Blinkinlabs/BlinkyPendant/README.md

# BlinkyPendant

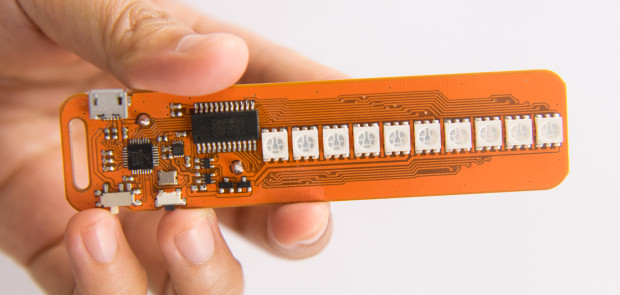
[picture p1: documentation/blinkypendant.jpg]


The BlinkyPendant is a pocket-sized POV wand, perfect for making light effects on the go!

See [http://blinkypendant.com](http://blinkypendant.com) for more details.
