Blinkinlabs/BlinkyPendant/pcb/art/BlinkyPendant.BMP

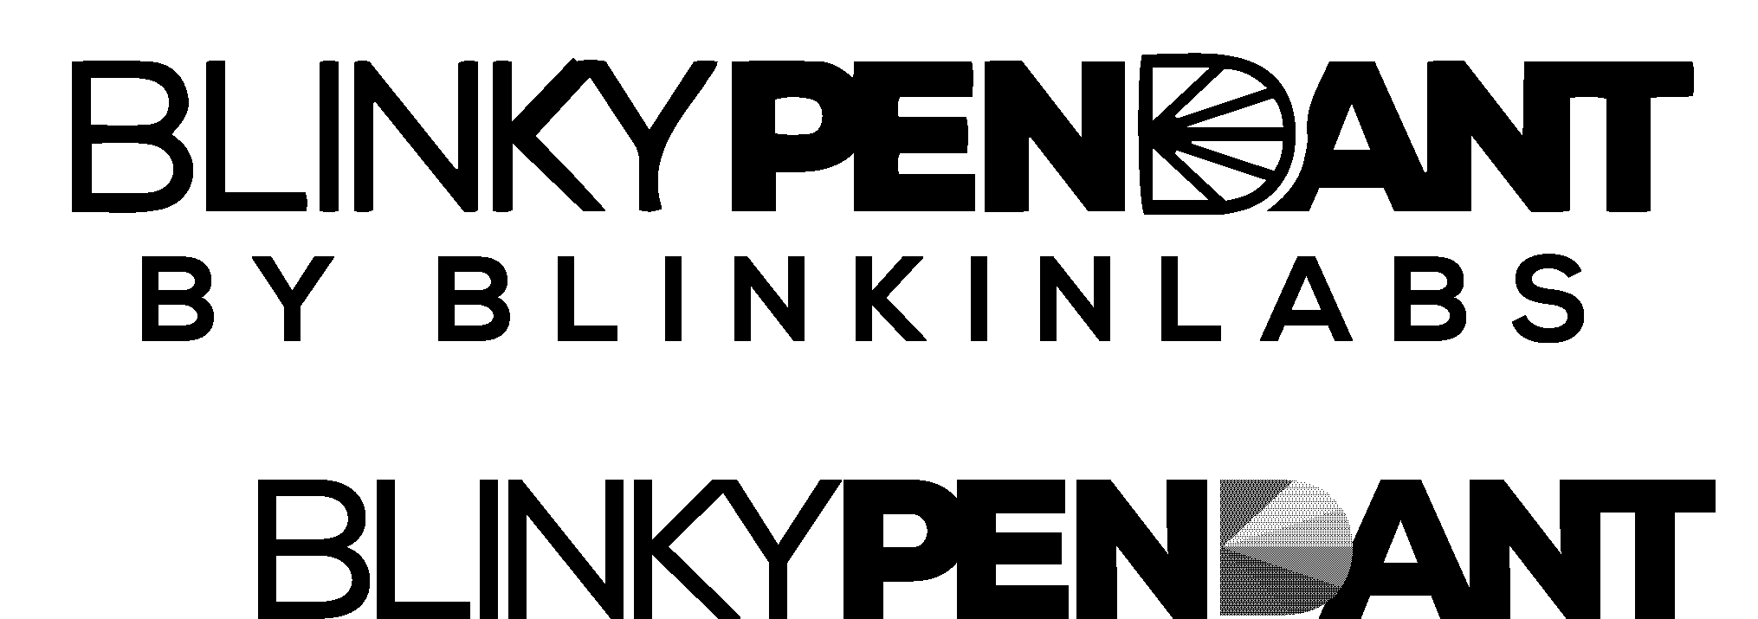
pcb/art/BlinkyPendant.BMP
