Blinkinlabs/BlinkyPendant/pcb/art/KinetisConnects_blackTEXT-1.BMP

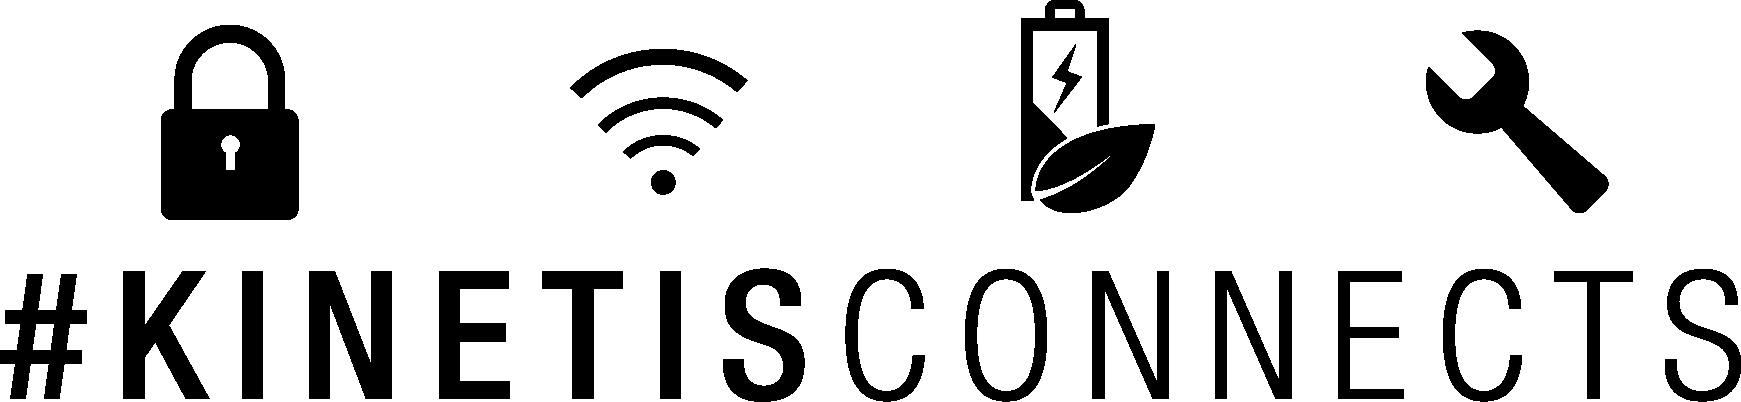
pcb/art/KinetisConnects_blackTEXT-1.BMP
