Blinkinlabs/BlinkyPendant/production/testcard/controller testjig.brd

## EAGLE design production/testcard/controller testjig.brd (2015-05-27)

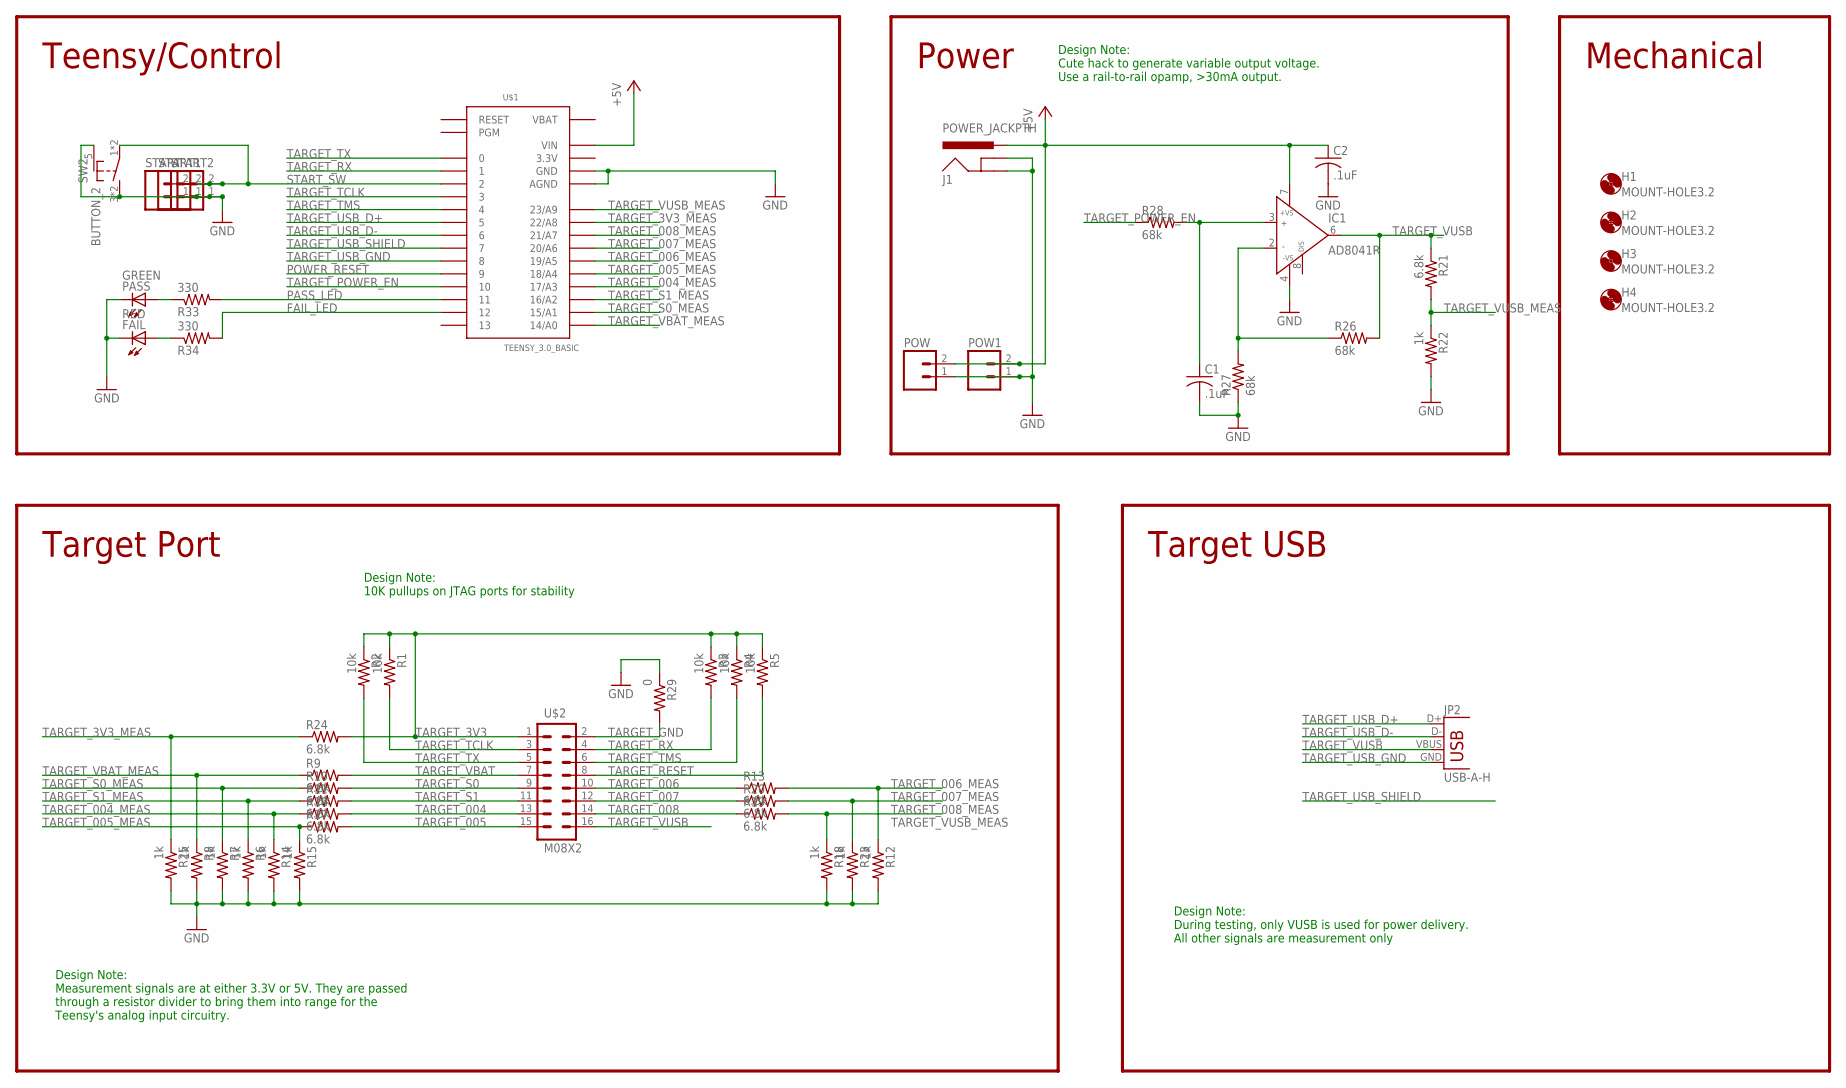
[picture p4: schematic controller testjig.sch]

Parts:
C1, C2: .1uF; C0603
FAIL: RED; LED5MM
H1, H2, H3, H4: MOUNT-HOLE3.2; 3,2
IC1: AD8041R; SO8
J1: POWER_JACKPTH; POWER_JACK_PTH
JP2: USB-A-H
PASS: GREEN; LED5MM
POW, POW1: M02; 02P
R1, R2, R3, R4, R5: 10k; R0603
R6, R7, R8, R12, R14, R15, R18, R22, R23, R25: 1k; R0603
R9, R10, R11, R13, R16, R17, R19, R20, R21, R24: 6.8k; R0603
R26, R27, R28: 68k; R0603
R29: 0; R0603
R33, R34: 330; R0603
START, START1, START2: M02; 02P
SW2: BUTTON_2; TD-07XB
U$1: TEENSY_3.0_BASIC
U$2: M08X2; 2X8

Connections:
3.3V: U$1.3.3V, U$1.3.3V1 (3.3V)
+5V: C2.1, IC1.7 (+VS), J1.PWR, POW.2, POW1.2, U$1.VIN
FAIL_LED: R34.2, U$1.12
GND: C1.2, C2.2, FAIL.K (C), IC1.4 (-VS), J1.GND, J1.GNDBREAK, PASS.K (C), POW.1, POW1.1, R6.2, R7.2, R8.2, R12.2, R14.2, R15.2, R18.2, R22.2, R23.2, R25.2, R27.1, R29.1, START.1, START1.1, START2.1, SW2.3 (S), SW2.4 (S), SW2.5 (SHIELD), U$1.AGND, U$1.GND, U$1.GND1 (GND)
GOOD: PASS.A, R33.1
unnamed: IC1.2 (IN-), R26.1, R27.2
unnamed: C1.1, IC1.3 (IN+), R28.2
unnamed: FAIL.A, R34.1
PASS_LED: R33.2, U$1.11
POWER_RESET: U$1.9
START_SW: START.2, START1.2, START2.2, SW2.1, SW2.2, U$1.2
TARGET_3V3: R1.1, R2.1, R3.1, R4.1, R5.1, R24.2, U$2.1
TARGET_3V3_MEAS: R24.1, R25.1, U$1.22/A8
TARGET_004: R16.2, U$2.13
TARGET_004_MEAS: R14.1, R16.1, U$1.17/A3
TARGET_005: R17.2, U$2.15
TARGET_005_MEAS: R15.1, R17.1, U$1.18/A4
TARGET_006: R13.1, U$2.10
TARGET_006_MEAS: R12.1, R13.2, U$1.19/A5
TARGET_007: R20.1, U$2.12
TARGET_007_MEAS: R20.2, R23.1, U$1.20/A6
TARGET_008: R19.1, U$2.14
TARGET_008_MEAS: R18.1, R19.2, U$1.21/A7
TARGET_GND: R29.2, U$2.2
TARGET_POWER_EN: R28.1, U$1.10
TARGET_RESET: R5.2, U$2.8
TARGET_RX: R3.2, U$1.1, U$2.4
TARGET_S0: R10.2, U$2.9
TARGET_S0_MEAS: R7.1, R10.1, U$1.15/A1
TARGET_S1: R11.2, U$2.11
TARGET_S1_MEAS: R6.1, R11.1, U$1.16/A2
TARGET_TCLK: R1.2, U$1.3, U$2.3
TARGET_TMS: R4.2, U$1.4, U$2.6
TARGET_TX: R2.2, U$1.0, U$2.5
TARGET_USB_D+: JP2.D+, U$1.5
TARGET_USB_D-: JP2.D-, U$1.6
TARGET_USB_GND: JP2.GND, U$1.8
TARGET_USB_SHIELD: U$1.7
TARGET_VBAT: R9.2, U$2.7
TARGET_VBAT_MEAS: R8.1, R9.1, U$1.14/A0
TARGET_VUSB: IC1.6 (OUT), JP2.VBUS, R21.1, R26.2, U$2.16
TARGET_VUSB_MEAS: R21.2, R22.1, U$1.23/A9
VBAT: U$1.VBAT

Notes on the sheet:
Teensy/Control
Target Port
Design Note: Measurement signals are at either 3.3V or 5V. They are passed through a resistor divider to bring them into range for the Teensy's analog input circuitry.
Design Note: 10K pullups on JTAG ports for stability
Mechanical
Target USB
Power
Design Note: During testing, only VUSB is used for power delivery. All other signals are measurement only
Design Note: Cute hack to generate variable output voltage. Use a rail-to-rail opamp, >30mA output.

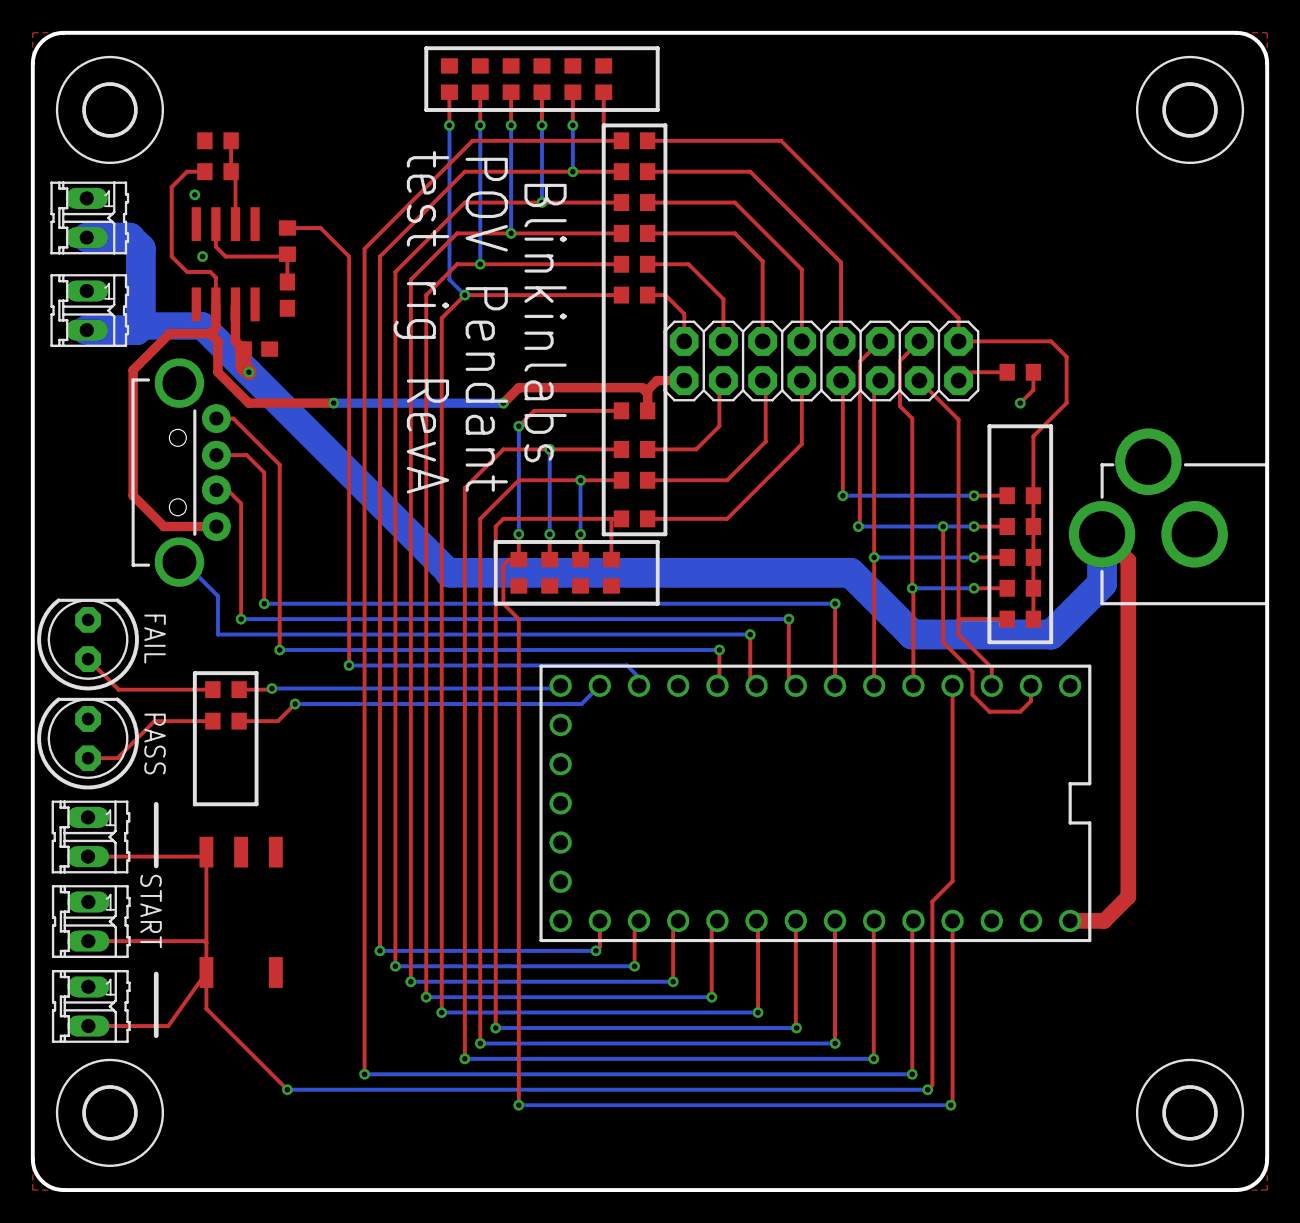
[picture p5: board controller testjig.brd from above]

Board: 2 copper layers, 80.0 x 75.0 mm, 50 parts (0 on the bottom side), 40 nets.
