Blinkinlabs/BlinkyPendant/pcb/pendant.brd

## EAGLE design pcb/pendant.brd (2015-05-27)

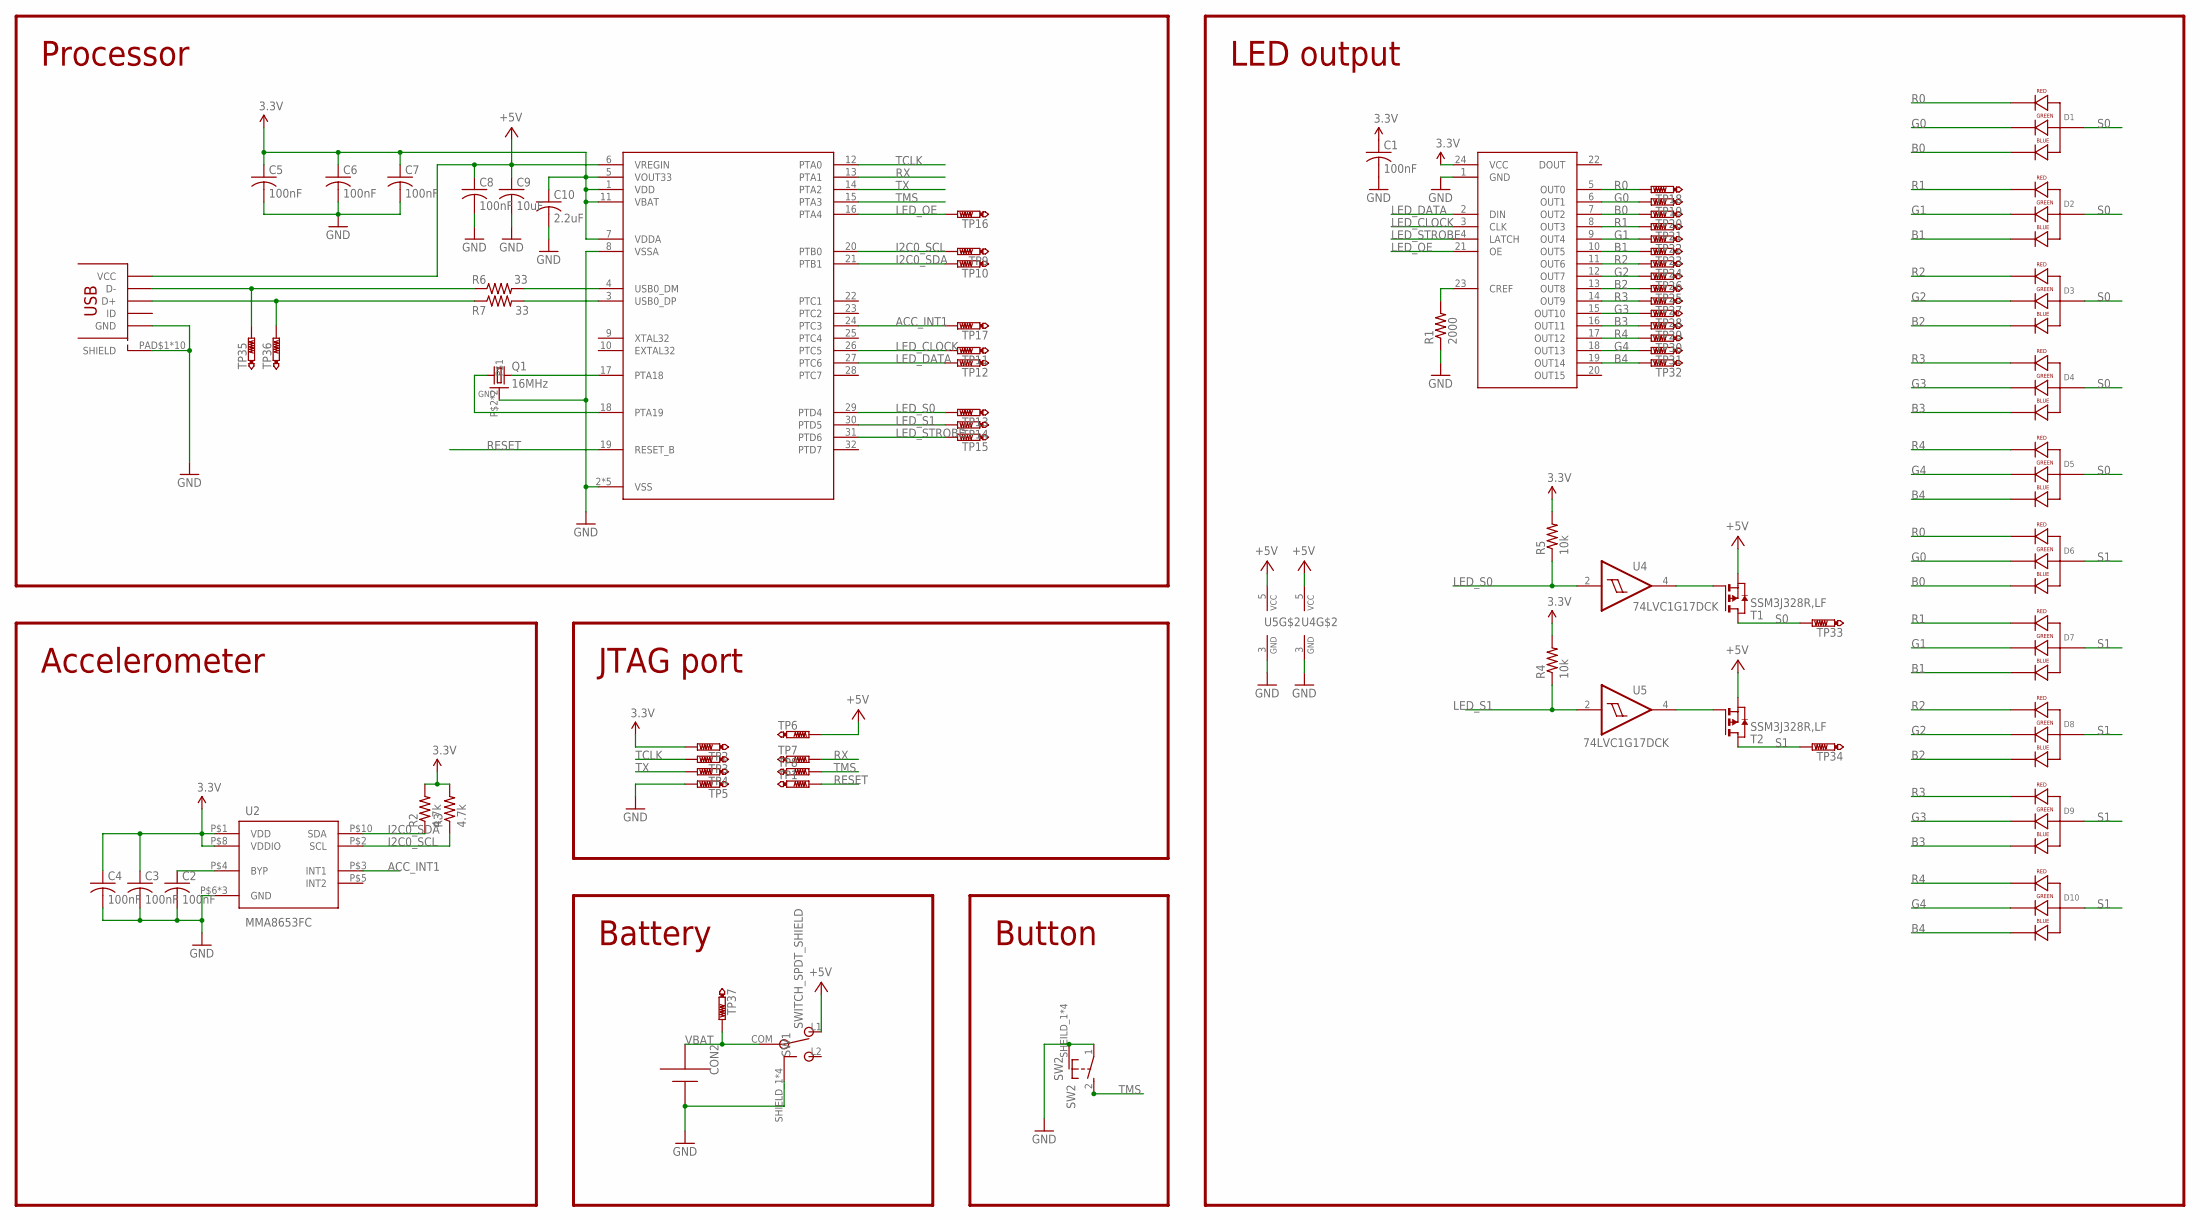
[picture p6: schematic pendant.sch]

Parts:
C1, C2, C3, C4, C5, C6, C7, C8: 100nF; C0402
C9: 10uF; C0603
C10: 2.2uF; C0402
CON1: USB_MICROSMT+THRUHULE; USB_MICRO_THRUHOLE
CON2: CR2032X2
D1, D2, D3, D4, D5, D6, D7, D8, D9, D10: LED-RGB5050; LED-TRICOLOR-5050-FIXED
Q1: 16MHz; CRYSTAL_3225
R1: 2000; R0402
R2, R3: 4.7k; R0402
R4, R5: 10k; R0402
R6, R7: 33; R0402
SW1: SWITCH_SPDT_SHIELD; SWITCH_SMD_90_DEGREE
SW2: SW2; BUTTON_MOMENTARY_MP5
T1, T2: SSM3J328R,LF; SOT-23
TP1, TP2, TP3, TP4, TP5, TP6, TP7, TP8, TP9, TP10, TP11, TP12, TP13, TP14, TP15, TP16, TP17, TP18, TP19, TP20, TP21, TP22, TP23, TP24, TP25, TP26, TP27, TP28, TP29, TP30, TP31, TP32, TP33, TP34, TP35, TP36, TP37: PTR1B1,27; B1,27
U1: MK20D--VFM5; QFN32_5X5_LONGLEADS
U2: MMA8653FC; VFDFN-10
U3: ICN2026DF; SMD-24-1MM
U4, U5: 74LVC1G17DCK; SC70-5

Connections:
3.3V: C1.1, C3.1, C4.1, C5.1, C6.1, C7.1, C10.1, R2.2, R3.2, R4.2, R5.2, TP2.TP, U1.1 (VDD), U1.5 (VOUT33), U1.7 (VDDA), U1.11 (VBAT), U2.P$1 (VDD), U2.P$8 (VDDIO), U3.24 (VCC)
+5V: C8.1, C9.1, CON1.PIN$1 (VCC), SW1.L1, T1.2 (S), T2.2 (S), TP6.TP, U1.6 (VREGIN), U4.5 (VCC), U5.5 (VCC)
ACC_INT1: TP17.TP, U1.24 (PTC3), U2.P$3 (INT1)
B0: D1.1 (BLUE_CATHODE), D6.1 (BLUE_CATHODE), TP20.TP, U3.7 (OUT2)
B1: D2.1 (BLUE_CATHODE), D7.1 (BLUE_CATHODE), TP23.TP, U3.10 (OUT5)
B2: D3.1 (BLUE_CATHODE), D8.1 (BLUE_CATHODE), TP25.TP, U3.13 (OUT8)
B3: D4.1 (BLUE_CATHODE), D9.1 (BLUE_CATHODE), TP29.TP, U3.16 (OUT11)
B4: D5.1 (BLUE_CATHODE), D10.1 (BLUE_CATHODE), TP32.TP, U3.19 (OUT14)
G0: D1.3 (GREEN_CATHODE), D6.3 (GREEN_CATHODE), TP19.TP, U3.6 (OUT1)
G1: D2.3 (GREEN_CATHODE), D7.3 (GREEN_CATHODE), TP22.TP, U3.9 (OUT4)
G2: D3.3 (GREEN_CATHODE), D8.3 (GREEN_CATHODE), TP26.TP, U3.12 (OUT7)
G3: D4.3 (GREEN_CATHODE), D9.3 (GREEN_CATHODE), TP28.TP, U3.15 (OUT10)
G4: D5.3 (GREEN_CATHODE), D10.3 (GREEN_CATHODE), TP31.TP, U3.18 (OUT13)
GND: C1.2, C2.2, C3.2, C4.2, C5.2, C6.2, C7.2, C8.2, C9.2, C10.2, CON1.PAD$1 (SHIELD), CON1.PAD$2 (SHIELD), CON1.PAD$3 (SHIELD), CON1.PAD$4 (SHIELD), CON1.PAD$5 (SHIELD), CON1.PAD$6 (SHIELD), CON1.PAD$7 (SHIELD), CON1.PAD$8 (SHIELD), CON1.PAD$9 (SHIELD), CON1.PAD$10 (SHIELD), CON1.PIN$5 (GND), CON2.-, Q1.P$2, Q1.P$4, R1.1, SW1.SHIELD_1 (SHIELD), SW1.SHIELD_2 (SHIELD), SW1.SHIELD_3 (SHIELD), SW1.SHIELD_4 (SHIELD), SW2.1, SW2.SHEILD_1 (SHIELD), SW2.SHEILD_2 (SHIELD), SW2.SHEILD_3 (SHIELD), SW2.SHEILD_4 (SHIELD), TP5.TP, U1.2 (VSS), U1.8 (VSSA), U1.PAD@1 (VSS), U1.PAD@4 (VSS), U1.PAD@9 (VSS), U1.PAD@11 (VSS), U2.P$6 (GND), U2.P$7 (GND), U2.P$9 (GND), U3.1 (GND), U4.3 (GND), U5.3 (GND)
I2C0_SCL: R3.1, TP9.TP, U1.20 (PTB0), U2.P$2 (SCL)
I2C0_SDA: R2.1, TP10.TP, U1.21 (PTB1), U2.P$10 (SDA)
LED_CLOCK: TP11.TP, U1.26 (PTC5), U3.3 (CLK)
LED_DATA: TP12.TP, U1.27 (PTC6), U3.2 (DIN)
LED_OE: TP16.TP, U1.16 (PTA4), U3.21 (OE)
LED_S0: R5.1, TP13.TP, U1.29 (PTD4), U4.2 (I)
LED_S1: R4.1, TP14.TP, U1.30 (PTD5), U5.2 (I)
LED_STROBE: TP15.TP, U1.31 (PTD6), U3.4 (LATCH)
unnamed: T2.3 (G), U5.4 (O)
unnamed: C2.1, U2.P$4 (BYP)
unnamed: T1.3 (G), U4.4 (O)
unnamed: Q1.P$3 (2), U1.17 (PTA18)
unnamed: Q1.P$1 (1), U1.18 (PTA19)
unnamed: CON1.PIN$3 (D+), R7.1, TP36.TP
unnamed: R6.2, U1.4 (USB0_DM)
unnamed: R7.2, U1.3 (USB0_DP)
unnamed: R1.2, U3.23 (CREF)
unnamed: CON1.PIN$2 (D-), R6.1, TP35.TP
R0: D1.2 (RED_CATHODE), D6.2 (RED_CATHODE), TP18.TP, U3.5 (OUT0)
R1: D2.2 (RED_CATHODE), D7.2 (RED_CATHODE), TP21.TP, U3.8 (OUT3)
R2: D3.2 (RED_CATHODE), D8.2 (RED_CATHODE), TP24.TP, U3.11 (OUT6)
R3: D4.2 (RED_CATHODE), D9.2 (RED_CATHODE), TP27.TP, U3.14 (OUT9)
R4: D5.2 (RED_CATHODE), D10.2 (RED_CATHODE), TP30.TP, U3.17 (OUT12)
RESET: TP1.TP, U1.19 (RESET_B)
RX: TP7.TP, U1.13 (PTA1)
S0: D1.4 (ANODE), D1.5 (ANODE), D1.6 (ANODE), D2.4 (ANODE), D2.5 (ANODE), D2.6 (ANODE), D3.4 (ANODE), D3.5 (ANODE), D3.6 (ANODE), D4.4 (ANODE), D4.5 (ANODE), D4.6 (ANODE), D5.4 (ANODE), D5.5 (ANODE), D5.6 (ANODE), T1.1 (D), TP33.TP
S1: D6.4 (ANODE), D6.5 (ANODE), D6.6 (ANODE), D7.4 (ANODE), D7.5 (ANODE), D7.6 (ANODE), D8.4 (ANODE), D8.5 (ANODE), D8.6 (ANODE), D9.4 (ANODE), D9.5 (ANODE), D9.6 (ANODE), D10.4 (ANODE), D10.5 (ANODE), D10.6 (ANODE), T2.1 (D), TP34.TP
TCLK: TP3.TP, U1.12 (PTA0)
TMS: SW2.2 (S), TP8.TP, U1.15 (PTA3)
TX: TP4.TP, U1.14 (PTA2)
VBAT: CON2.+, SW1.COM, TP37.TP

Notes on the sheet:
Accelerometer
LED output
Processor
JTAG port
Battery
Button

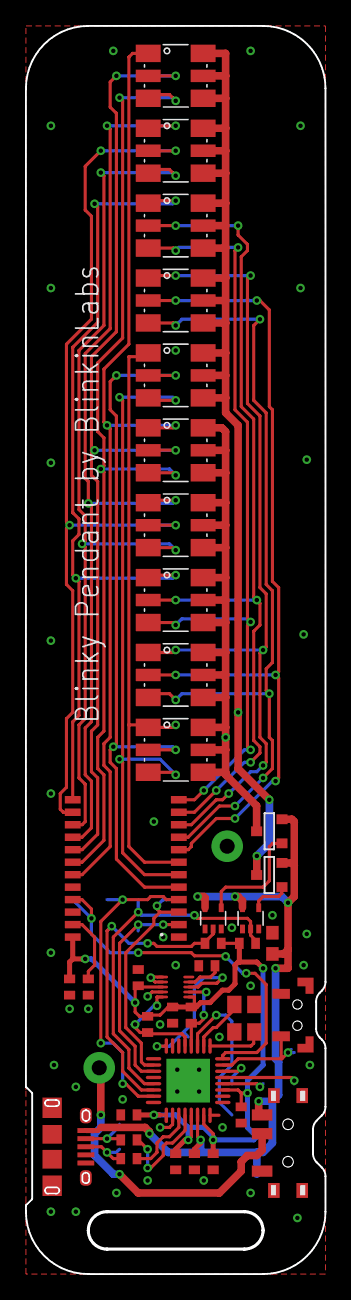
[picture p7: board pendant.brd from above]

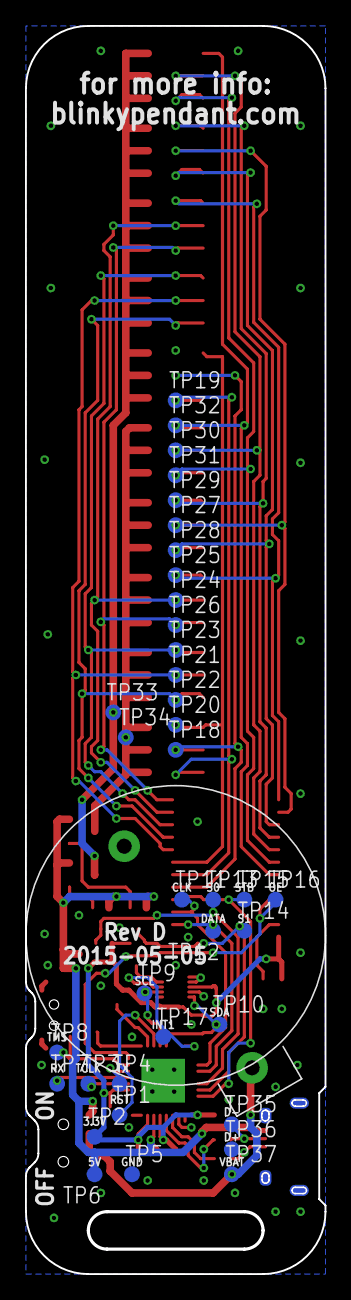
[picture p8: board pendant.brd from below]

Board: 2 copper layers, 24.0 x 100.0 mm, 76 parts (38 on the bottom side), 45 nets.
