Blinkinlabs/BlinkyPendant/production/test/production/fc_remote.cpp

/*
 * Remote control for the Fadecandy firmware, using the ARM debug interface.
 * 
 * Copyright (c) 2013 Micah Elizabeth Scott
 * 
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
 * THE SOFTWARE IS PROVIDED "AS IS", WITHOUT WARRANTY OF ANY KIND, EXPRESS OR
 * IMPLIED, INCLUDING BUT NOT LIMITED TO THE WARRANTIES OF MERCHANTABILITY, FITNESS
 * FOR A PARTICULAR PURPOSE AND NONINFRINGEMENT. IN NO EVENT SHALL THE AUTHORS OR
 * COPYRIGHT HOLDERS BE LIABLE FOR ANY CLAIM, DAMAGES OR OTHER LIABILITY, WHETHER
 * IN AN ACTION OF CONTRACT, TORT OR OTHERWISE, ARISING FROM, OUT OF OR IN
 * CONNECTION WITH THE SOFTWARE OR THE USE OR OTHER DEALINGS IN THE SOFTWARE.
 */

#include <Arduino.h>
#include "fc_remote.h"
#include "testjig.h"
#include "firmware_data.h"
#include "mma8653_defines.h"

// TODO: DELETE ME!
#define fw_pFlags 0x00FFFFFF
#define fw_pFbPrev 0x00FFFFFF
#define fw_pFbNext 0x00FFFFFF
#define fw_pLUT 0x00FFFFFF
#define fw_usbPacketBufOffset 0x00FFFFFF

bool FcRemote::installFirmware()
{
    // Install firmware, blinking both target and local LEDs in unison.

    bool blink = false;
    static int i = 0;
    ARMKinetisDebug::FlashProgrammer programmer(target, fw_data, fw_sectorCount);

    if (!programmer.begin())
        return false;

    while (!programmer.isComplete()) {
        if (!programmer.next()) return false;
        
        if((i++ % 128) == 0) {
            blink = !blink;
            if (!setLED(blink)) return false;
            digitalWrite(ledPin, blink);
        }
    }

    return true;
}

bool FcRemote::boot()
{ 
    // Run the new firmware, and let it boot
    if (!target.reset())
        return false;
    delay(50);
    return true;
}

bool FcRemote::setLED(bool on)
{
    const unsigned pin = target.PTD6;
    return
        target.pinMode(pin, OUTPUT) &&
        target.digitalWrite(pin, !on);
}

bool FcRemote::setFlags(uint8_t cflag)
{
    // Set control flags    
    return target.memStoreByte(fw_pFlags, cflag);
}


bool FcRemote::testAccelerometer()
{ 
    const unsigned interruptPin   = target.PTC3;
  
    target.log(target.LOG_NORMAL, "Accelerometer test: beginning accelerometer test");
    
    if(!target.I2C0begin())
        return false;

    target.log(target.LOG_NORMAL, "Accelerometer test: resetting accelerometer");
    // Reset the device, to put it into a known state.
    if(!(
        target.I2C0beginTransmission(MMA8653_ADDRESS) &&
        target.I2C0write(CTRL_REG2) &&
        target.I2C0write(CTRL_REG2_RST) &&
        target.I2C0endTransmission()))
        return false;

    delay(10); // Allow the device to reset
    
    
    // Now, check that the interrupt pin is clear
    if(!target.pinMode(interruptPin, INPUT_PULLUP))
        return false;
        
    if(target.digitalRead(interruptPin) == LOW)
        return false;
    

    target.log(target.LOG_NORMAL, "Accelerometer test: asking for device ID");
    // Check that we're talking to the right kind of device
    if(!(
        target.I2C0beginTransmission(MMA8653_ADDRESS) &&
        target.I2C0write(WHO_AM_I) &&
        target.I2C0endTransmission(false)))
        return false;

    target.log(target.LOG_NORMAL, "Accelerometer test: receiving device ID");
    target.I2C0requestFrom(MMA8653_ADDRESS, 1);
    while(target.I2C0available()) {
      uint8_t throwaway;
      target.I2C0receive(throwaway);
      // TODO: Test if this is equal to 0x5A?
    }
    
    target.log(target.LOG_NORMAL, "Accelerometer test: enable data ready interrupt");
    // Enable data ready interrupt on interrput pin 1
    if(!(
        target.I2C0beginTransmission(MMA8653_ADDRESS) &&
        target.I2C0write(CTRL_REG4) &&
        target.I2C0write(CTRL_REG4_INT_EN_DRDY) &&
        target.I2C0endTransmission() &&

        target.I2C0beginTransmission(MMA8653_ADDRESS) &&
        target.I2C0write(CTRL_REG5) &&
        target.I2C0write(CTRL_REG5_INT_CFG_DRDY) &&
        target.I2C0endTransmission()))
        return false;

    target.log(target.LOG_NORMAL, "Accelerometer test: set fast-read mode");
    // Put in fast-read mode, with 800Hz output rate, and activate
    if(!(
        target.I2C0beginTransmission(MMA8653_ADDRESS) &&
        target.I2C0write(CTRL_REG1) &&
        target.I2C0write(CTRL_REG1_ACTIVE | CTRL_REG1_F_READ | CTRL_REG1_DR(0)) &&
        target.I2C0endTransmission()))
        return false;
    
    delay(10); // Data should be ready in <3
    
    // Check that an interrupt occurred
    if(target.digitalRead(interruptPin) == HIGH)
        return false;
    
    // Read XYZ data
    int8_t X, Y, Z;
    if(!(
        target.I2C0beginTransmission(MMA8653_ADDRESS) &&
        target.I2C0write(STATUS) &&
        target.I2C0endTransmission(false) &&
        target.I2C0requestFrom(MMA8653_ADDRESS, 4) &&
        target.I2C0available() &&
        target.I2C0receive((uint8_t&)X) && // Ignore this one
        target.I2C0available() &&
        target.I2C0receive((uint8_t&)X) &&
        target.I2C0available() &&
        target.I2C0receive((uint8_t&)Y) &&
        target.I2C0available() &&
        target.I2C0receive((uint8_t&)Z)))
        return false;
        
    target.log(target.LOG_NORMAL, "Accelerometer data (X=%i, Y=%i, Z=%i)",X,Y,Z);
    
    // Check the range
    const int bounds = 10;
    const int Xtarget= 0;
    const int Ytarget= 0;
    const int Ztarget= 64;
    if((X > Xtarget + bounds) || (X < Xtarget - bounds) ||
        (Y > Ytarget + bounds) || (Y < Ytarget - bounds) ||
        (Z > Ztarget + bounds) || (Z < Ztarget - bounds))
        return false;
    
    return true;
}

bool FcRemote::setLEDData(bool* data)
{
    const unsigned dataPin   = target.PTC6;
    const unsigned clockPin  = target.PTC5;
    const unsigned strobePin = target.PTD6;

    // Bitbang some SPI out, hit strobe
    for(int i = 0; i < 15; i++) {
        if(!(
            target.digitalWrite(dataPin, data[i]?HIGH:LOW) &&
            target.digitalWrite(clockPin, HIGH) &&
            target.digitalWrite(clockPin, LOW)))
            return false;
    }
    
    if(!(
        target.digitalWrite(strobePin, HIGH) &&
        target.digitalWrite(strobePin, LOW)))
        return false;
}

bool FcRemote::showColor(int color, int loops)
{
    const unsigned oePin     = target.PTA4;
    const unsigned S0Pin     = target.PTD4;
    const unsigned S1Pin     = target.PTD5;
  
    bool ledStates[15];
    
    for(int i = 0; i < 15; i++) {
        if(((color & 0x1) && (i%3 == 0)) ||
            ((color & 0x2) && (i%3 == 1)) ||
            ((color & 0x4) && (i%3 == 2))) {
          ledStates[i] = true;
        }
        else {
          ledStates[i] = false;
        }
    }
    
    if(!(setLEDData(ledStates)))
        return false;

    // Enable OE
    if(!(
        target.digitalWrite(oePin, LOW)))
        return false;
        
    for(int i = 0; i < loops; i++) {
        if(!(
            target.digitalWrite(S0Pin, LOW) &&
            target.digitalWrite(S0Pin, HIGH) &&
            target.digitalWrite(S1Pin, LOW) &&
            target.digitalWrite(S1Pin, HIGH)))
            return false;
    }
    
    // Disable OE
    if(!(
        target.digitalWrite(oePin, LOW)))
        return false;

}

bool FcRemote::testLEDOutputs()
{
    const unsigned dataPin   = target.PTC6;
    const unsigned clockPin  = target.PTC5;
    const unsigned strobePin = target.PTD6;
    const unsigned oePin     = target.PTA4;
    const unsigned S0Pin     = target.PTD4;
    const unsigned S1Pin     = target.PTD5;

  
    target.log(target.LOG_NORMAL, "LED driver test: configuring pins");

  
    // Set pinmodes for Data, Clock, Strobe, OE
    if(!(
        target.pinMode(dataPin,   OUTPUT) &&
        target.pinMode(clockPin,  OUTPUT) &&
        target.pinMode(strobePin, OUTPUT) &&
        target.pinMode(oePin,     OUTPUT) &&
        target.pinMode(S0Pin,     OUTPUT) &&
        target.pinMode(S1Pin,     OUTPUT) &&
        target.digitalWrite(strobePin, HIGH) &&
        target.digitalWrite(oePin,     HIGH) &&
        target.digitalWrite(clockPin,  LOW) &&
        target.digitalWrite(S0Pin,     HIGH) &&
        target.digitalWrite(S1Pin,     HIGH)))
        return false;

    
    target.log(target.LOG_NORMAL, "LED driver test: colors");

    showColor(1,200);
    showColor(2,200);
    showColor(4,200);
    showColor(1|2|4,400);
    

    target.log(target.LOG_NORMAL, "LED driver test: done");
    return true;
}

//bool FcRemote::testUserButtons()
//{
//    // Button pins to test
//    const unsigned button2Pin = target.PTD5;
//    const unsigned button1Pin = target.PTD7;
//    
//    if(!target.pinMode(button1Pin,INPUT_PULLUP))
//        return false;
//    if(!target.pinMode(button2Pin,INPUT_PULLUP))
//        return false;
//        
//    // Button should start high
//    if(!target.digitalRead(button1Pin)) {
//        target.log(target.LOG_ERROR, "BUTTON: Button 1 stuck low");
//        return false;
//    }
//    if(!target.digitalRead(button2Pin)) {
//        target.log(target.LOG_ERROR, "BUTTON: Button 2 stuck low");
//        return false;
//    }
//        
//    target.log(target.LOG_NORMAL, "BUTTON: Waiting for user to press button 1");
//
//    const int FLASH_SPEED = 200;
//
//    while(target.digitalRead(button1Pin)) {
//        static bool blink = false;
//        static int i = 0;
//        
//        if((i++ % FLASH_SPEED) == 0) {
//            blink = !blink;
//            if (!setLED(blink)) return false;
//            digitalWrite(ledPin, blink);
//        }
//    }
//
//    target.log(target.LOG_NORMAL, "BUTTON: Waiting for user to release button 1");
//
//    while(!target.digitalRead(button1Pin)) {
//        static bool blink = false;
//        static int i = 0;
//        
//        if((i++ % FLASH_SPEED) == 0) {
//            blink = !blink;
//            if (!setLED(blink)) return false;
//            digitalWrite(ledPin, blink);
//        }
//    }
//    
//    target.log(target.LOG_NORMAL, "BUTTON: Waiting for user to press button 2");
//
//    while(target.digitalRead(button2Pin)) {
//        static bool blink = false;
//        static int i = 0;
//        
//        if((i++ % FLASH_SPEED) == 0) {
//            blink = !blink;
//            if (!setLED(blink)) return false;
//            digitalWrite(ledPin, blink);
//        }
//    }
//    
//    target.log(target.LOG_NORMAL, "BUTTON: Waiting for user to release button 2");
//    
//    while(!target.digitalRead(button2Pin)) {
//        static bool blink = false;
//        static int i = 0;
//        
//        if((i++ % FLASH_SPEED) == 0) {
//            blink = !blink;
//            if (!setLED(blink)) return false;
//            digitalWrite(ledPin, blink);
//        }
//    }
//    
//    target.log(target.LOG_NORMAL, "BUTTON: Buttons ok.");
//    return true;
//}

//bool FcRemote::testExternalFlash()
//{
//    target.log(target.LOG_NORMAL, "External flash test: Beginning external flash test");
//    
//    ////// Initialize the SPI hardware
//    if (!target.initializeSpi0())
//        return false;
//    
//    ////// Identify the flash
//    
//    if(!target.sendSpi0(0x9F, false)) {
//        target.log(target.LOG_ERROR, "External flash test: Error communicating with device.");
//        return false;
//    }
//
//    const int JEDEC_ID_LENGTH = 3;
//    uint8_t receivedId[JEDEC_ID_LENGTH];
//
//    for(int i = 0; i < JEDEC_ID_LENGTH; i++) {
//        if(!target.receiveSpi0(receivedId[i], (JEDEC_ID_LENGTH - 1) == i)) {
//            target.log(target.LOG_ERROR, "External flash test: Error communicating with device.");
//            return false;
//        }
//    }
//    
//    if((receivedId[0] != 0x01) | (receivedId[1] != 0x40) | (receivedId[2] != 0x15)) {    // Spansion 16m
////    if((receivedId[0] != 0xEF) | (receivedId[1] != 0x40) | (receivedId[2] != 0x14)) {    // Winbond 8m
//        target.log(target.LOG_ERROR, "External flash test: Invalid device type, got %02X%02X%02X", receivedId[0], receivedId[1], receivedId[2]);
//        return false;
//    }
//    
//    ////// Erase the flash
//    
//    if(!target.sendSpi0(0x06, true)) {
//        target.log(target.LOG_ERROR, "External flash test: Error enabling flash write");
//        return false;
//    }
//
//    if(!target.sendSpi0(0xC7, true)) {
//        target.log(target.LOG_ERROR, "External flash test: Error sending erase command.");
//        return false;
//    }
//    
//    target.log(target.LOG_NORMAL, "External flash test: Erasing external flash");
//    
//    uint8_t sr;
//    do {
//        static bool blink = false;
//        static int i = 0;
//        const int FLASH_SPEED = 40;
//        
//        if((i++ % FLASH_SPEED) == 0) {
//            blink = !blink;
//            if (!setLED(blink)) return false;
//            digitalWrite(ledPin, blink);
//        }
//      
//      if(!target.sendSpi0(0x05, false)) {
//          target.log(target.LOG_ERROR, "External flash test: Error getting status report");
//          return false;
//      }
//      if(!target.receiveSpi0(sr, true)) {
//          target.log(target.LOG_ERROR, "External flash test: Error getting status report");
//          return false;
//      }
//    }
//    while(sr & 0x01);
//    
//    if(!target.sendSpi0(0x03, true)) {
//        target.log(target.LOG_ERROR, "External flash test: Error disabling flash write");
//        return false;
//    }
//    
//    
//    target.log(target.LOG_NORMAL, "External flash test: Successfully completed external flash test!");
//    return true;
//}
