Blinkinlabs/BlinkyPendant/firmware/blinkypendant.cpp

#include "WProgram.h"
#include "blinkypendant.h"

// Reserved RAM area for signalling entry to bootloader
extern uint32_t boot_token;

void initBoard() {
    setupWatchdog();
}


void dfu_reboot()
{
    // Reboot to the Fadecandy Bootloader
    boot_token = 0x74624346;

    // Short delay to allow the host to receive the response to DFU_DETACH.
    uint32_t deadline = millis() + 10;
    while (millis() < deadline) {
        watchdog_refresh();
    }

    // Detach from USB, and use the watchdog to time out a 10ms USB disconnect.
    __disable_irq();
    USB0_CONTROL = 0;
    while (1);
}


void setupWatchdog() {
    // Change the watchdog timeout because the SPI access is too slow.
    const uint32_t watchdog_timeout = F_BUS / 2;  // 500ms

    WDOG_UNLOCK = WDOG_UNLOCK_SEQ1;
    WDOG_UNLOCK = WDOG_UNLOCK_SEQ2;
    asm volatile ("nop");
    asm volatile ("nop");
    WDOG_STCTRLH = WDOG_STCTRLH_ALLOWUPDATE | WDOG_STCTRLH_WDOGEN |
        WDOG_STCTRLH_WAITEN | WDOG_STCTRLH_STOPEN | WDOG_STCTRLH_CLKSRC;
    WDOG_PRESC = 0;
    WDOG_TOVALH = (watchdog_timeout >> 16) & 0xFFFF;
    WDOG_TOVALL = (watchdog_timeout)       & 0xFFFF;
}
