Blinkinlabs/BlinkyPendant/firmware/SampleFilter.c

#include "SampleFilter.h"

static double filter_taps[SAMPLEFILTER_TAP_NUM] = {
  0.03946073714347548,
  0.11838248117085194,
  0.2071692727265806,
  0.24663000987005582,
  0.2071692727265806,
  0.11838248117085194,
  0.03946073714347548
};

void SampleFilter_init(SampleFilter* f) {
  int i;
  for(i = 0; i < SAMPLEFILTER_TAP_NUM; ++i)
    f->history[i] = 0;
  f->last_index = 0;
}

void SampleFilter_put(SampleFilter* f, double input) {
  f->history[f->last_index++] = input;
  if(f->last_index == SAMPLEFILTER_TAP_NUM)
    f->last_index = 0;
}

double SampleFilter_get(SampleFilter* f) {
  double acc = 0;
  int index = f->last_index, i;
  for(i = 0; i < SAMPLEFILTER_TAP_NUM; ++i) {
    index = index != 0 ? index-1 : SAMPLEFILTER_TAP_NUM-1;
    acc += f->history[index] * filter_taps[i];
  };
  return acc;
}
