Blinkinlabs/BlinkyPendant/(commit log)

2015-04-08 First commit, pull firmware from leoblinky, bootloader from blinkytile, new pcb design
    [pendant.brd, pendant.sch]
2015-04-08 Get things compiled, output not working yet
    [blinkytile.cpp, buttons.cpp, buttons.h, main.cpp]
2015-04-08 Almost there! Need to flip OE to timer 0.
2015-04-11 fix cap under ICN2026, change led output order, use 5050 LEDs, replace power and tach switches, use 10 LEDs, move test points out from battery
    [pendant.brd, pendant.sch]
2015-04-12 Update battery footprint
    [pendant.brd, pendant.sch]
2015-04-12 Display going, some bleeding and bit order is wrong.
    [matrix.cpp, matrix.h]
2015-04-12 Adding support for accelerometer
    [pendant.brd, pendant.sch]
2015-04-12 Accelerometer working with cheap 1 point derivative filter.
2015-04-13 Add interrupt line from accelerometer, clean up test pad positions
    [pendant.brd, pendant.sch]
2015-04-15 Update I2C speed
    [pendant.brd]
2015-04-17 Switching to class-based implementation
2015-04-19 Support switching between animations
2015-04-20 Closing in on RevC design
    [pendant.brd, pendant.sch]
2015-04-21 RevC PCB
    [pendant.brd, pendant.sch]
2015-04-21 POV: Use a timer to count time, rather than rely on millis()
2015-04-30 Add test jig RevA
    [controller testjig.brd, controller testjig.sch]
2015-05-05 Update board
    [controller testjig.brd, pendant.brd, pendant.sch]
2015-05-05 Add USB, VBAT test points
    [pendant.brd, pendant.sch]
2015-05-06 Update reference designators
    [pendant.brd, pendant.sch]
2015-05-08 Fix VBAT label (minor point)
    [pendant.brd]
2015-05-20 Update reference designators on the BOM
    [pendant.brd, pendant.sch]
2015-05-24 Update VID/PID
2015-05-24 Add some more sample images
2015-05-26 Bringing up the test rig
    [controller testjig.brd, controller testjig.sch]
2015-05-26 Add S0, S1 tests, begin I2C work for accelerometer
    [controller testjig.brd, controller testjig.sch]
2015-05-26 Broken accelerometer testing
2015-05-27 Fix target poweroff routine, add nonworking LED test
    [controller testjig.brd, controller testjig.sch]
2015-05-27 Working at high speed on Teensy 3.0. Problem was in the reset sequence.
    [electrical_test.cpp, production.ino]
2015-05-27 Fix bug in i2c register defines
    [electrical_test.cpp, electrical_test.h, fc_remote.cpp, fc_remote.h, production.ino]
2015-05-27 Add timeouts to I2C driver, so it can fail gracelfully
2015-05-27 Accelerometer test
2015-05-27 Accelerometer works, add white LED flashing
    [pendant.brd]
2015-05-28 Revert use of flexram in bootloader
    [bootloader.c, dfu.c]
2015-05-29 Production fix: can't use flexram for programming since it's not present
    [main.cpp, production.ino]
2015-05-30 Generate Windows drivers for the pendant
2015-05-30 Fix in listports to work with windows
    [listports.py]
2017-05-10 Fix pattern loading bug
    [serialloop.cpp]
2017-05-10 Bump version, replace LED_COUNT with DISPLAY_MODE
    [animation.cpp, animation.h, animations.cpp, animations.h, serialloop.cpp]
2017-05-10 Fix references to blinkytile
    [blinkypendant.cpp, blinkypendant.h, buttons.cpp, main.cpp, matrix.h, pov.cpp, serialloop.cpp]
2017-05-11 Bugfix: call matrixSetup() after write
    [main.cpp, serialloop.cpp]
2017-10-18 Move test code to production directory
    [controller testjig.brd, controller testjig.sch]
